lachlanjc/london-smog/README.md

# London Smog

This is a WIP project to experience air quality in VR with physical hardware: an inflatable neck pillow with a programmable air pump.

MIT License
