lachlanjc/london-smog/docs/src/content/docs/index.mdx

---
title: Project overview
description: Get started building your docs site with Starlight.
---

**London Smog** is a story about the history of air quality in London.
It has two parts: a website experience, ideally in VR, and a wearable pillow that inflates around your neck to simulate the air quality throughout the story in a physical way.

Presented at the [2024 ITP Winter Show](https://itp.nyu.edu/shows/winter2024/) in Downtown Brooklyn.

[**View website**](https://london-smog.vercel.app)

[Open source on GitHub](https://github.com/lachlanjc/london-smog)

<script src="https://cdn.jsdelivr.net/npm/@mux/mux-player"></script>

<mux-player
playback-id="vE8WEUNDKz02SDv1LWIsg1Udi02d1h3SECZc02h9vMeBsE"
poster="https://image.mux.com/vE8WEUNDKz02SDv1LWIsg1Udi02d1h3SECZc02h9vMeBsE/thumbnail.jpg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"></mux-player>

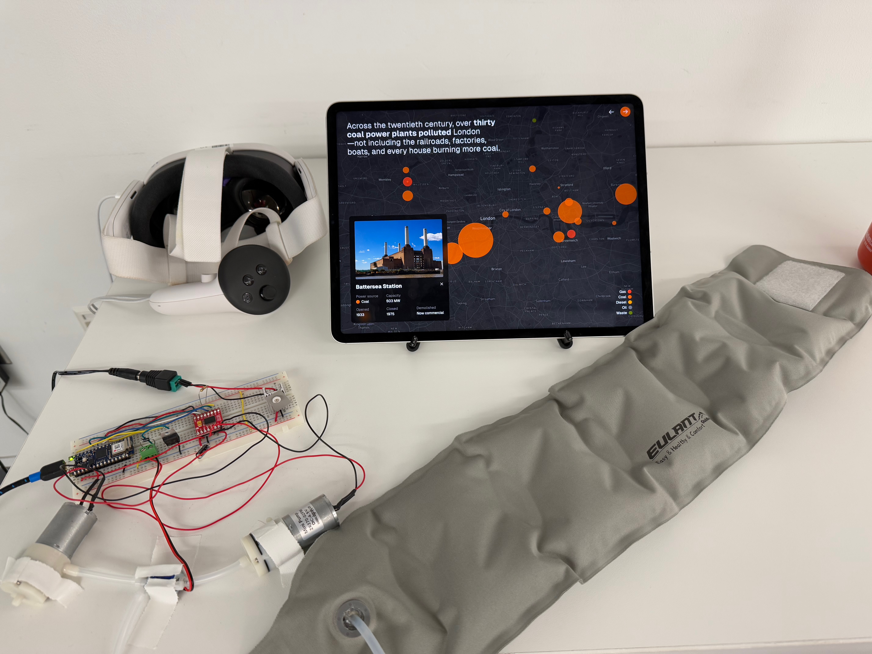
[picture p1: docs/src/assets/home/setup.jpeg]
Grey neck pillow outstretched on a table with a breadboard and air pumps alongside a Meta Quest 3 VR headset and iPad showing a map of London
