lachlanjc/london-smog/docs/src/content/docs/Documentation/inspiration.md

---
title: Inspiration
description: Evergreen
---

## Object

RAINS Bator jacket:

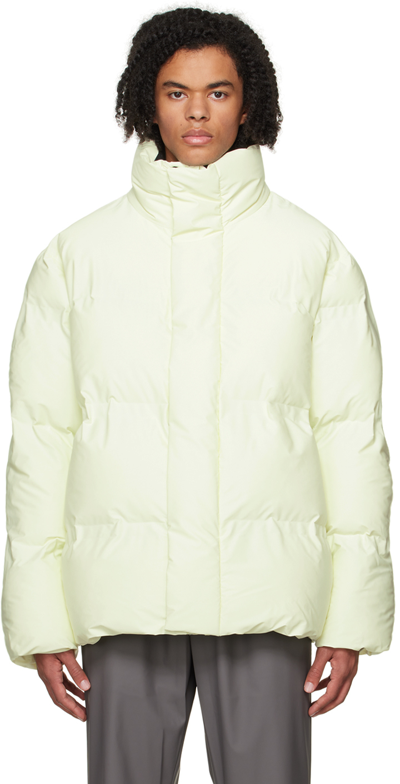
[picture p5: docs/src/assets/inspiration/rains.png]
Rains jacket


## Installation

NYU Berlin gallery opening Fingerfertigkeiten, December 2023:

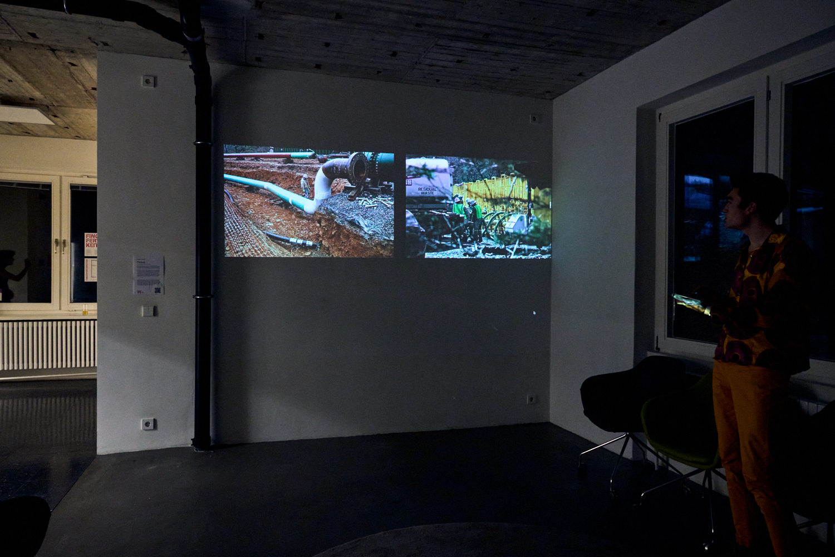
[picture p6: docs/src/assets/inspiration/opening_1.jpg]
Opening 1


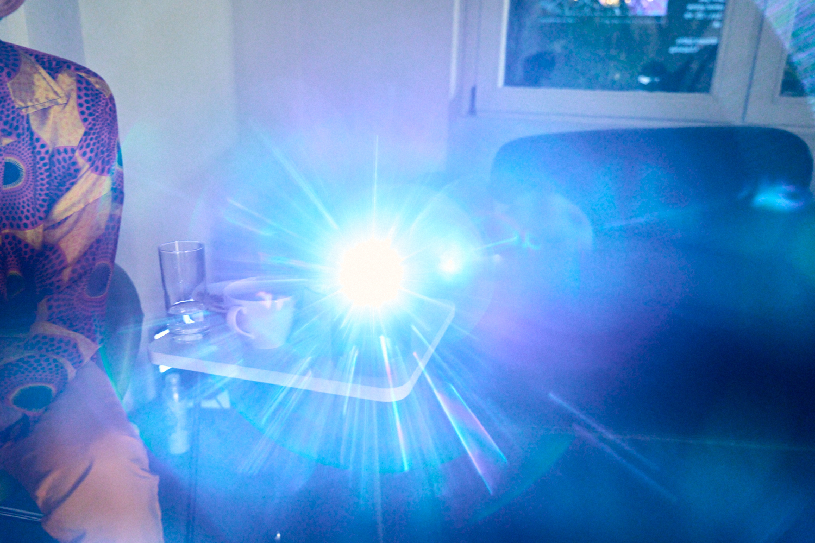
[picture p7: docs/src/assets/inspiration/opening_2.jpg]
Opening 2


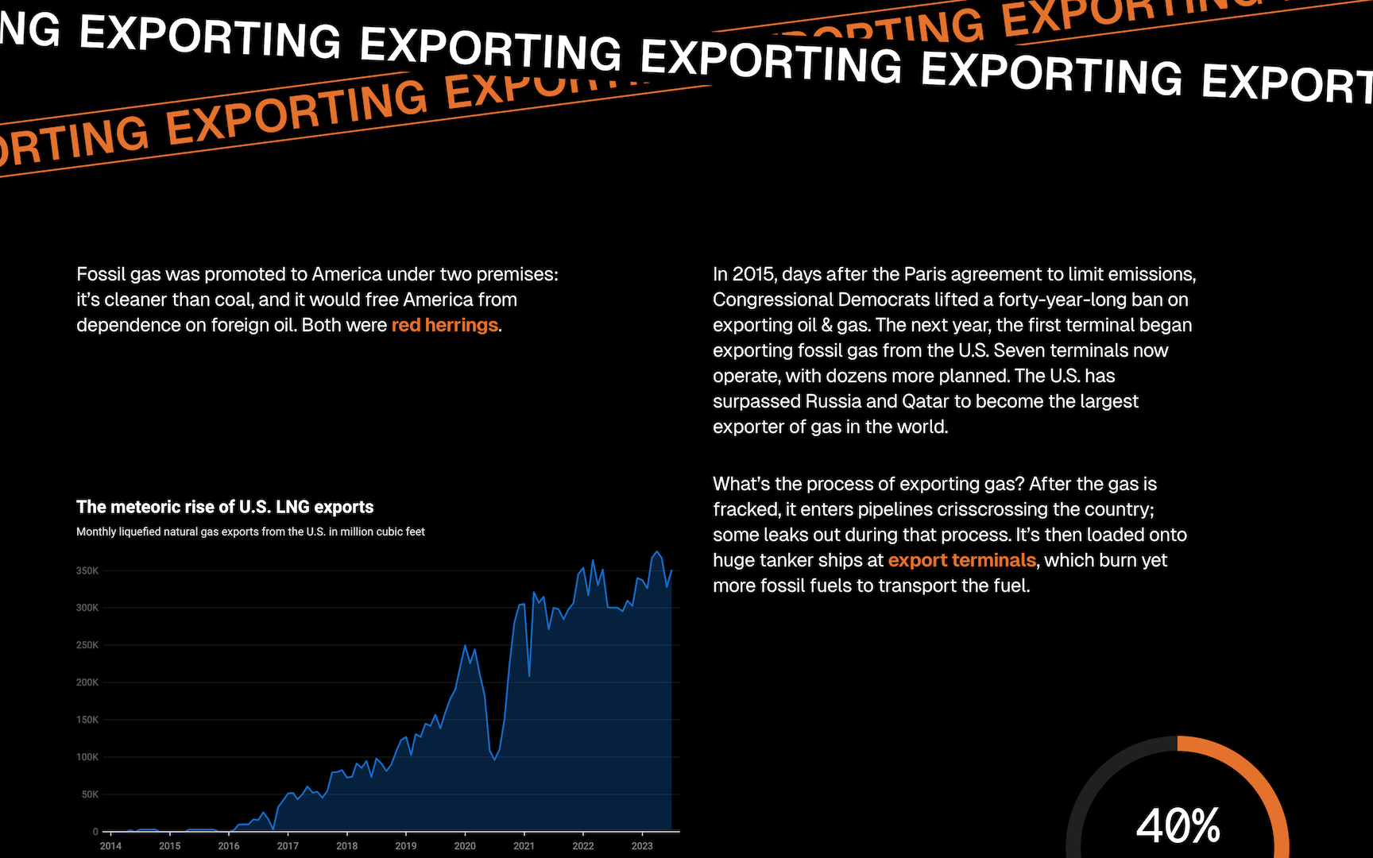
[picture p8: docs/src/assets/inspiration/flareup_story.png]
Flareup storytelling screenshot


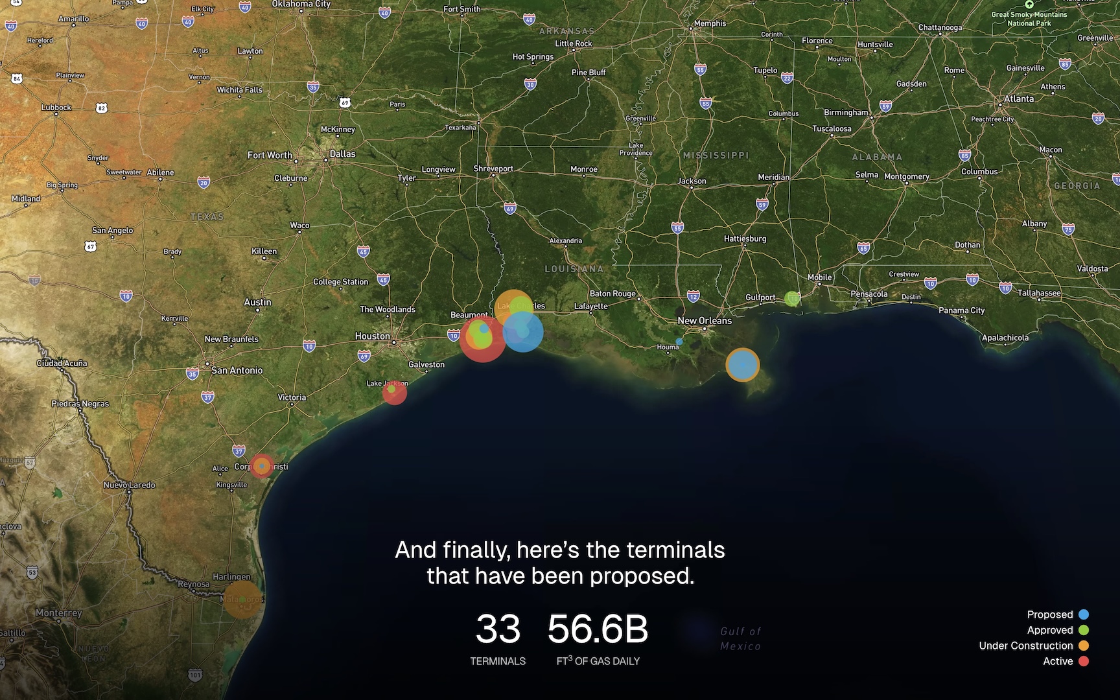
[picture p9: docs/src/assets/inspiration/flareup_map.jpeg]
Flareup map screenshot


## Data/storytelling

[_Our World in Data_: “What the history of London’s air pollution can tell us about the future of today’s growing megacities”](https://ourworldindata.org/london-air-pollution)

Widnes Smoke
