lachlanjc/london-smog/docs/src/content/docs/Past/midterm.md

---
title: Midterm presentation
description: Presented 2024-10-17
---

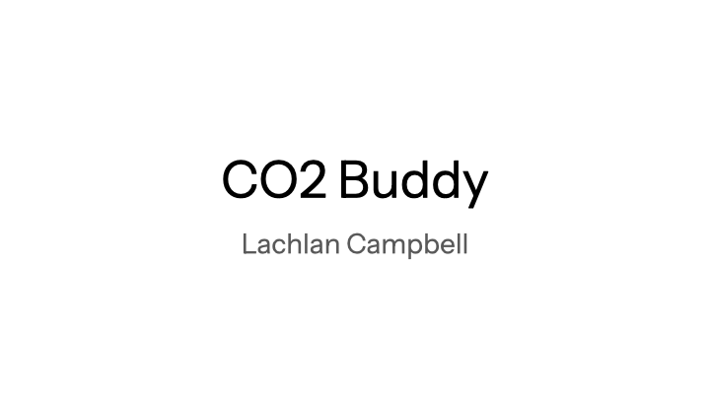
[picture p10: docs/src/assets/midterm/1.png]


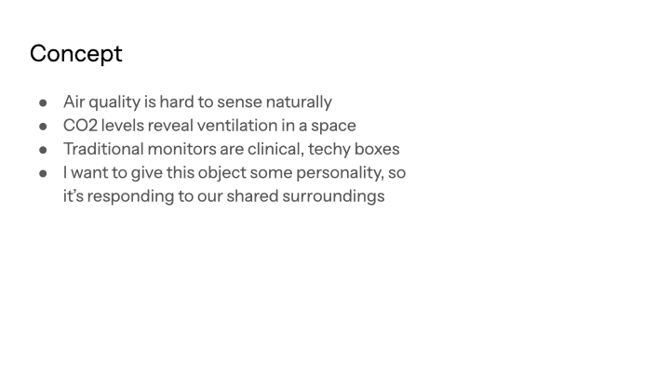
[picture p11: docs/src/assets/midterm/2.png]


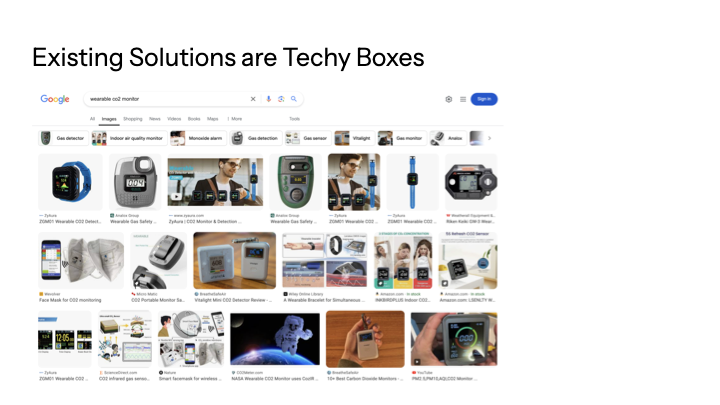
[picture p12: docs/src/assets/midterm/3.png]


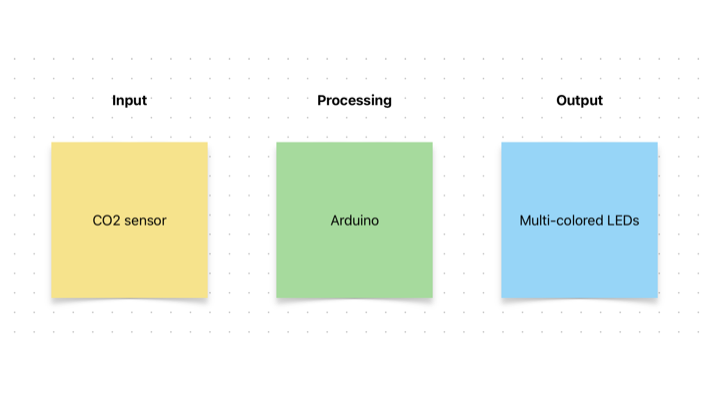
[picture p13: docs/src/assets/midterm/4.png]


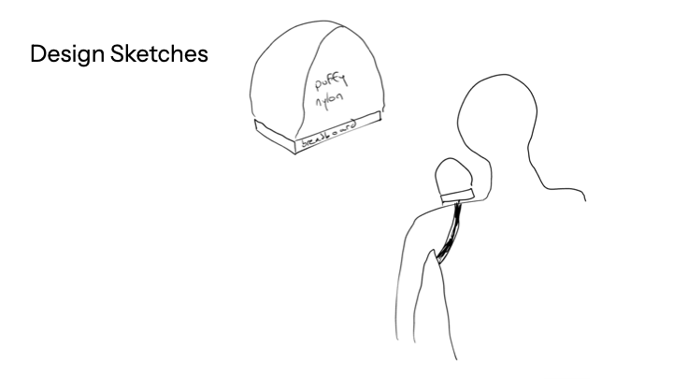
[picture p14: docs/src/assets/midterm/5.png]


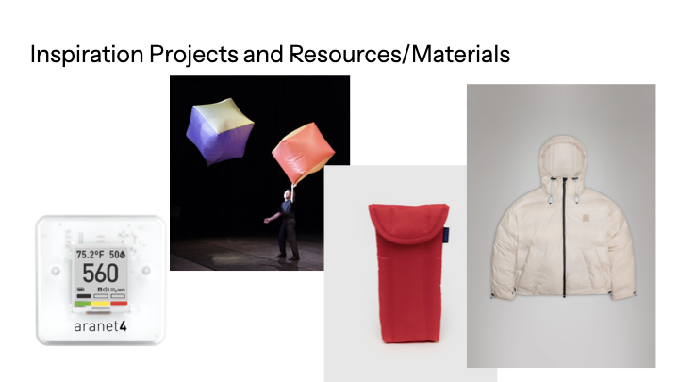
[picture p15: docs/src/assets/midterm/6.png]


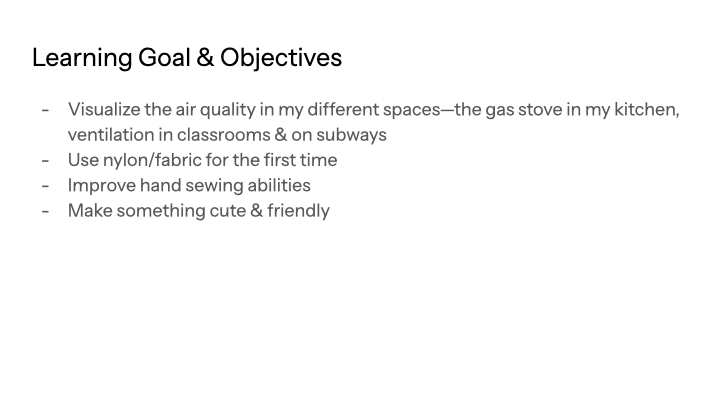
[picture p16: docs/src/assets/midterm/7.png]


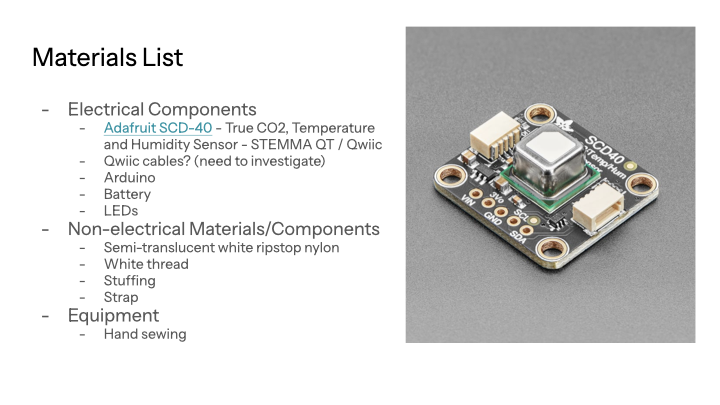
[picture p17: docs/src/assets/midterm/8.png]


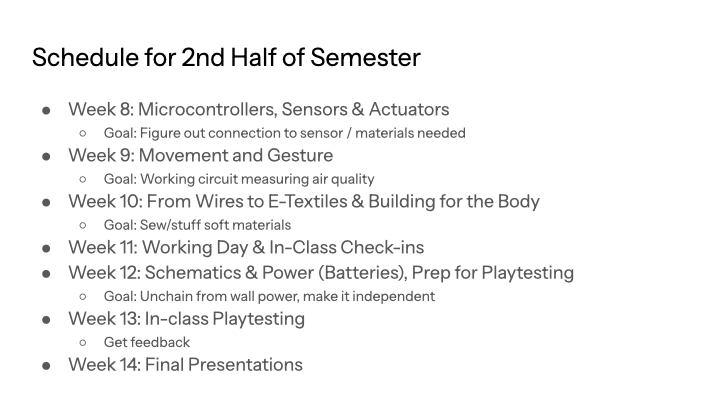
[picture p18: docs/src/assets/midterm/9.png]
