lachlanjc/london-smog/docs/src/assets/6/io_log.png

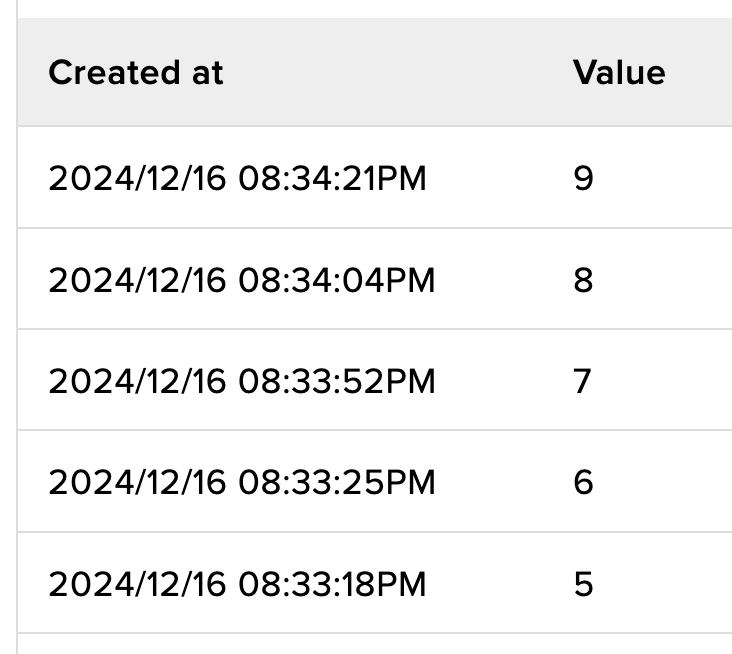
docs/src/assets/6/io_log.png
