lachlanjc/london-smog/docs/src/assets/home/me.jpeg

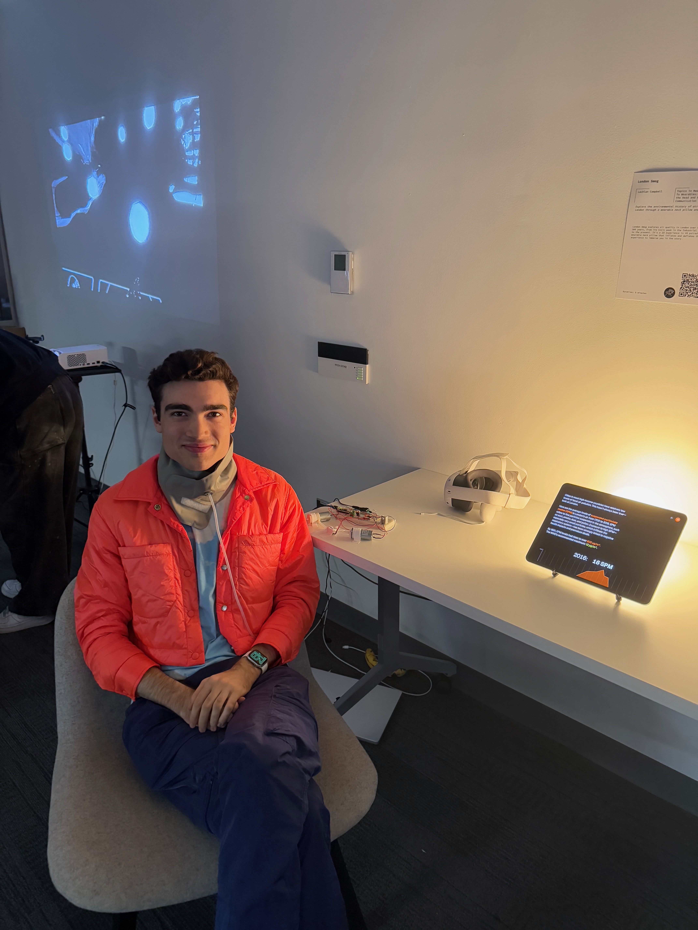
docs/src/assets/home/me.jpeg
