lachlanjc/london-smog/site/src/Air/battersea_crop.webp

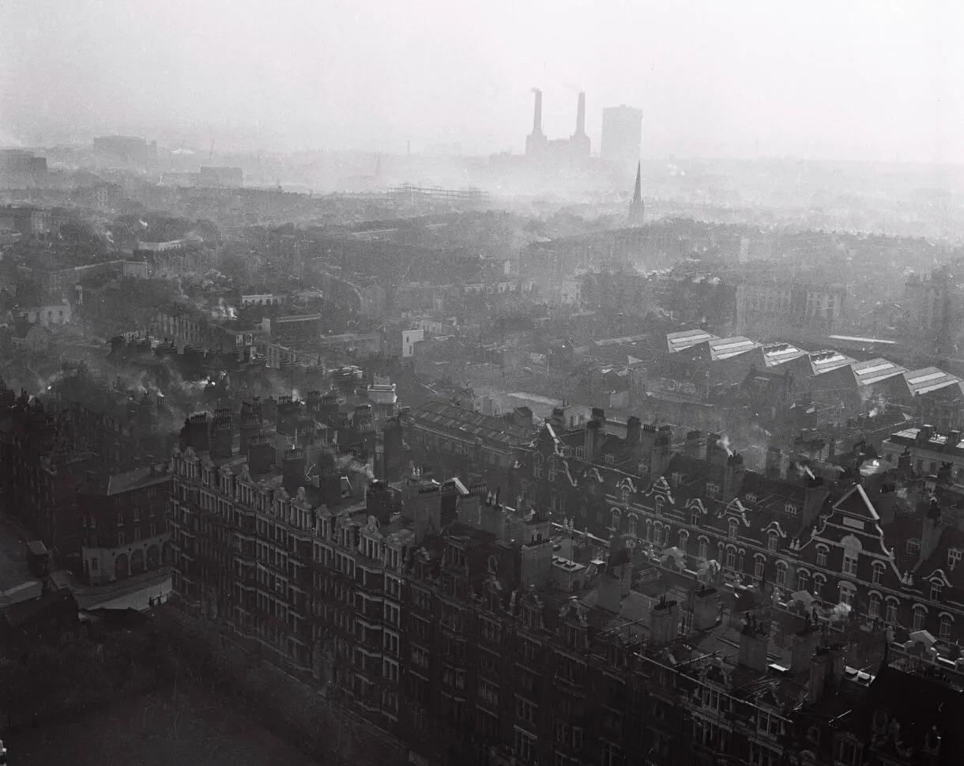
site/src/Air/battersea_crop.webp
