lachlanjc/london-smog/site/src/Air/rooftops.jpeg

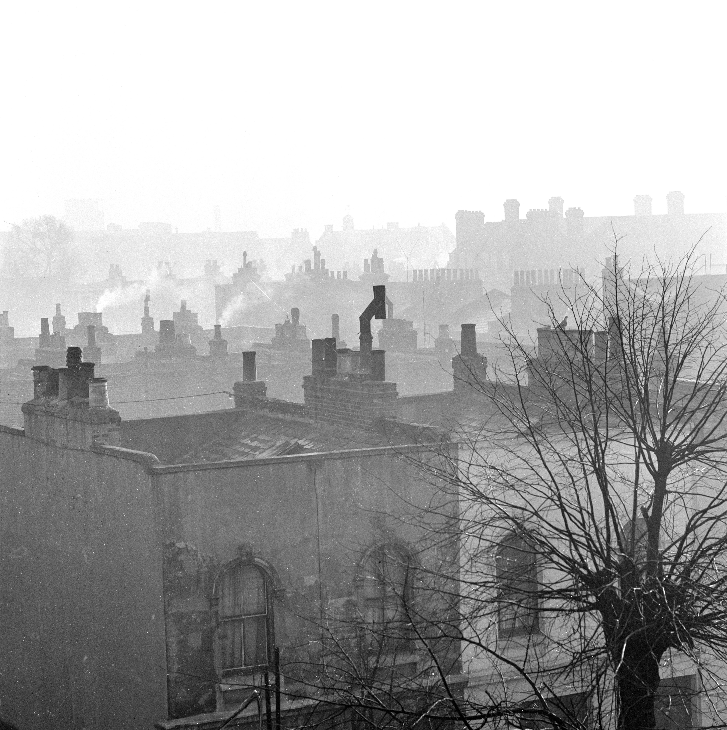
site/src/Air/rooftops.jpeg
