lachlanjc/london-smog/site/src/Air/rooftops.webp

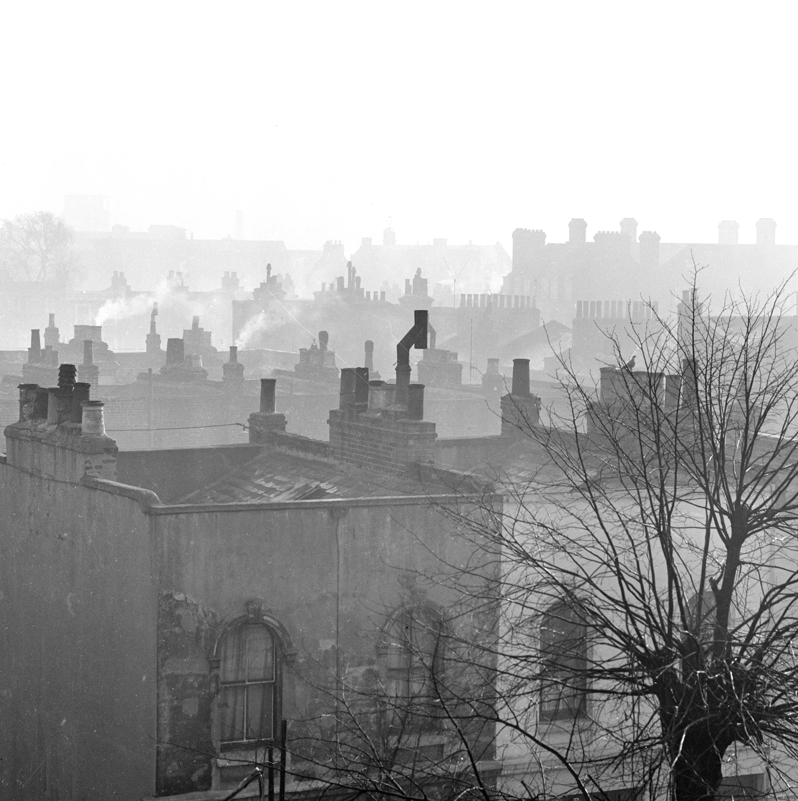
site/src/Air/rooftops.webp
