lachlanjc/london-smog/site/src/Closure/green.webp

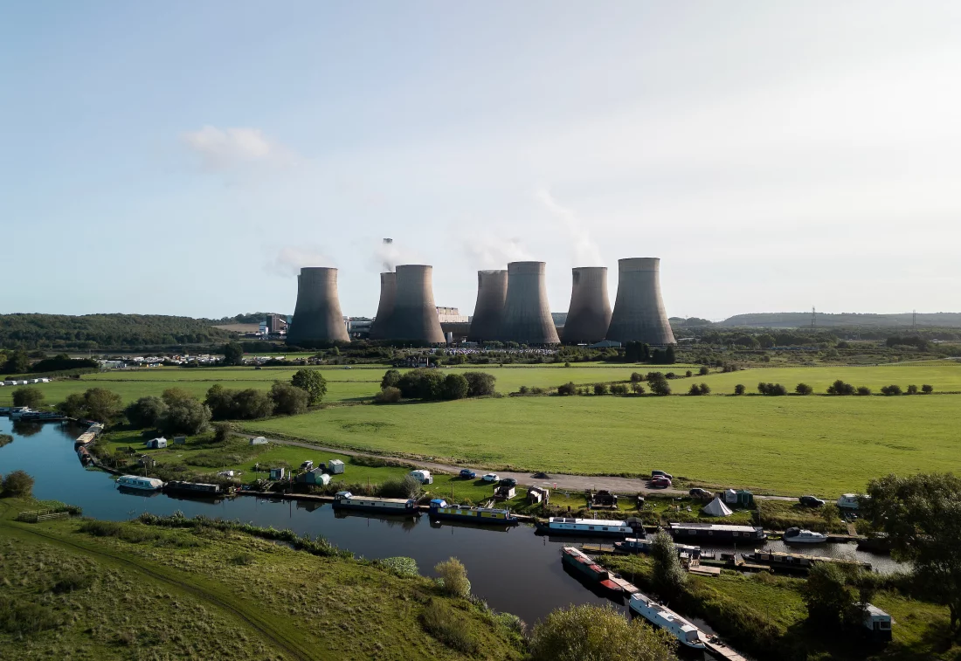
site/src/Closure/green.webp
