lachlanjc/london-smog/site/src/Closure/night.webp

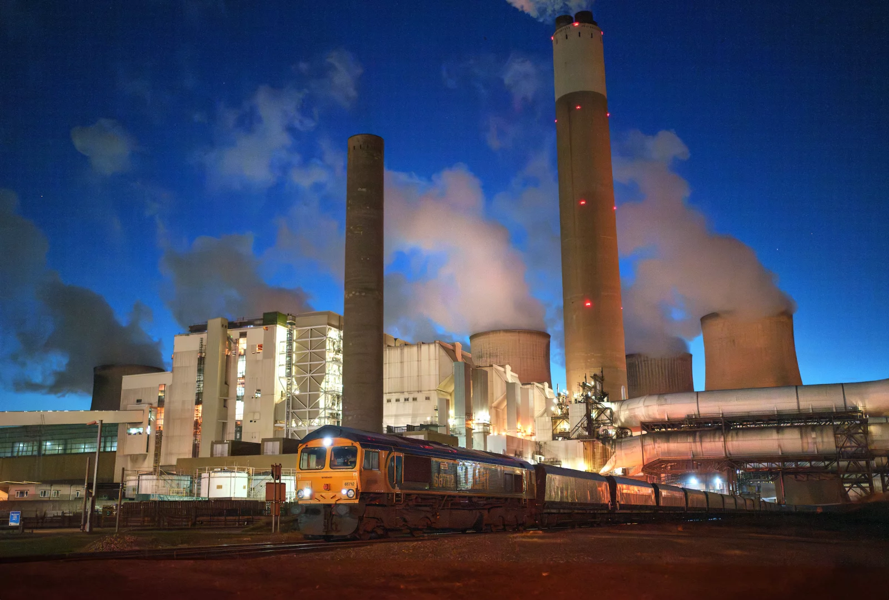
site/src/Closure/night.webp
