lachlanjc/london-smog/site/src/Closure/train.webp

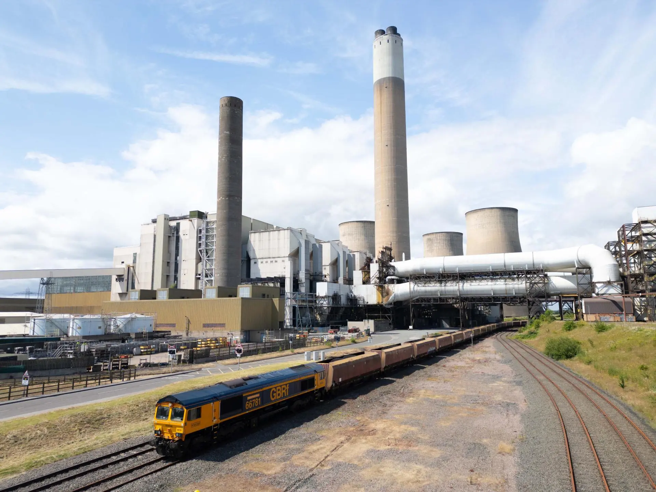
site/src/Closure/train.webp
