lachlanjc/london-smog/site/src/Closure/truck.webp

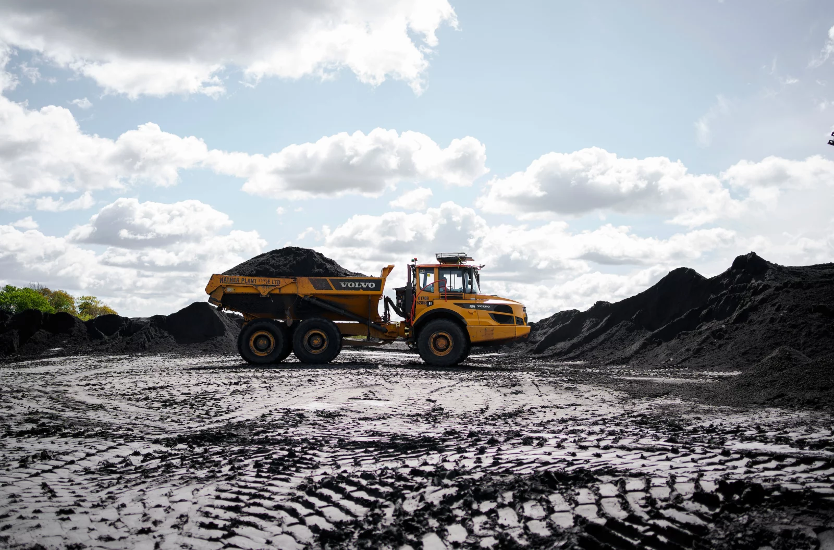
site/src/Closure/truck.webp
