lachlanjc/london-smog/site/src/Coal/boats.webp

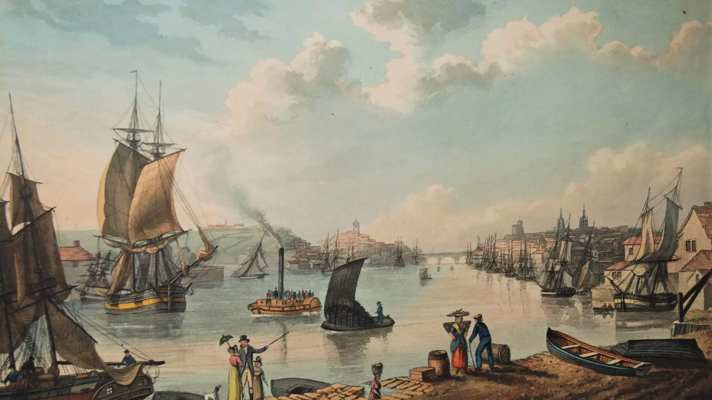
site/src/Coal/boats.webp
