lachlanjc/london-smog/site/src/Coal/landscape.webp

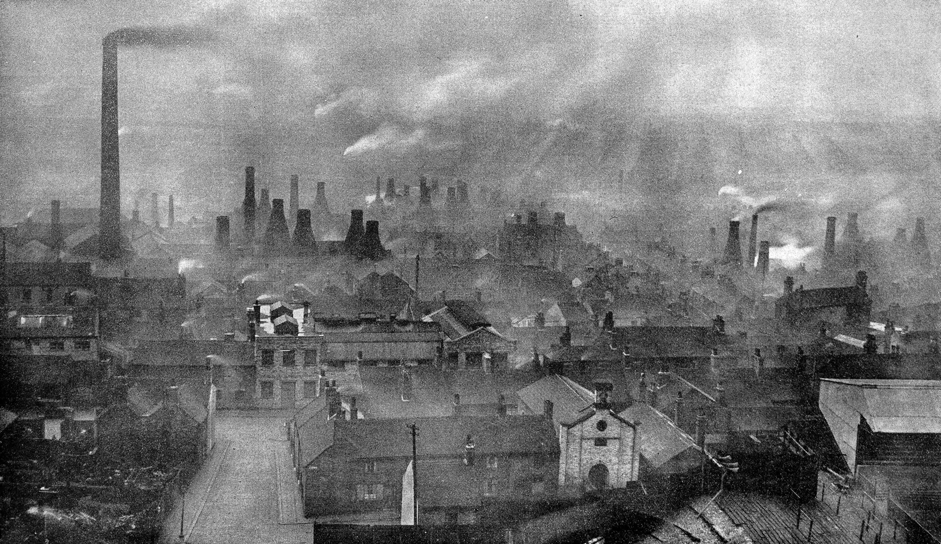
site/src/Coal/landscape.webp
