lachlanjc/london-smog/site/src/Coal/rooftops.webp

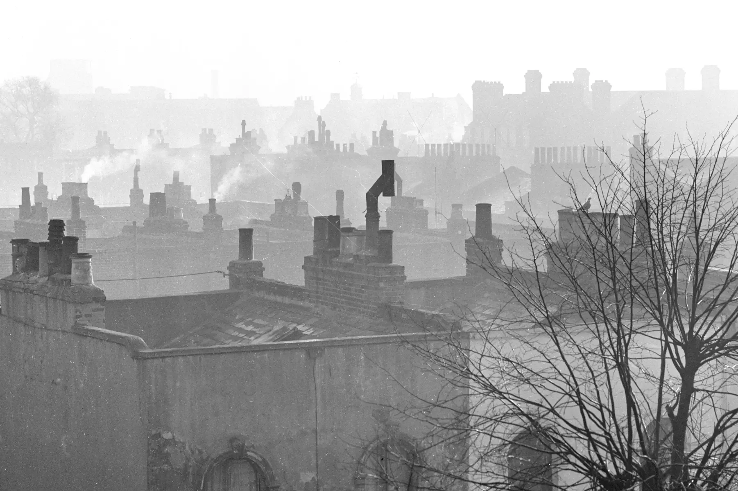
site/src/Coal/rooftops.webp
