lachlanjc/london-smog/site/src/Coal/thomas.webp

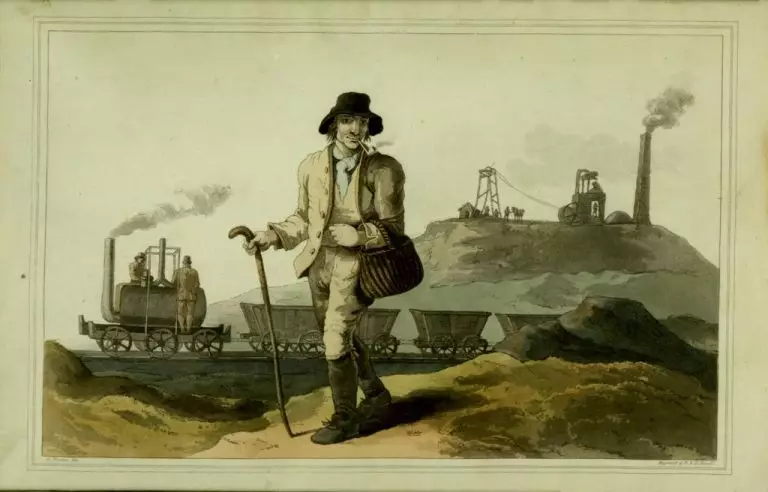
site/src/Coal/thomas.webp
