lachlanjc/london-smog/site/src/Congestion/hero.jpg

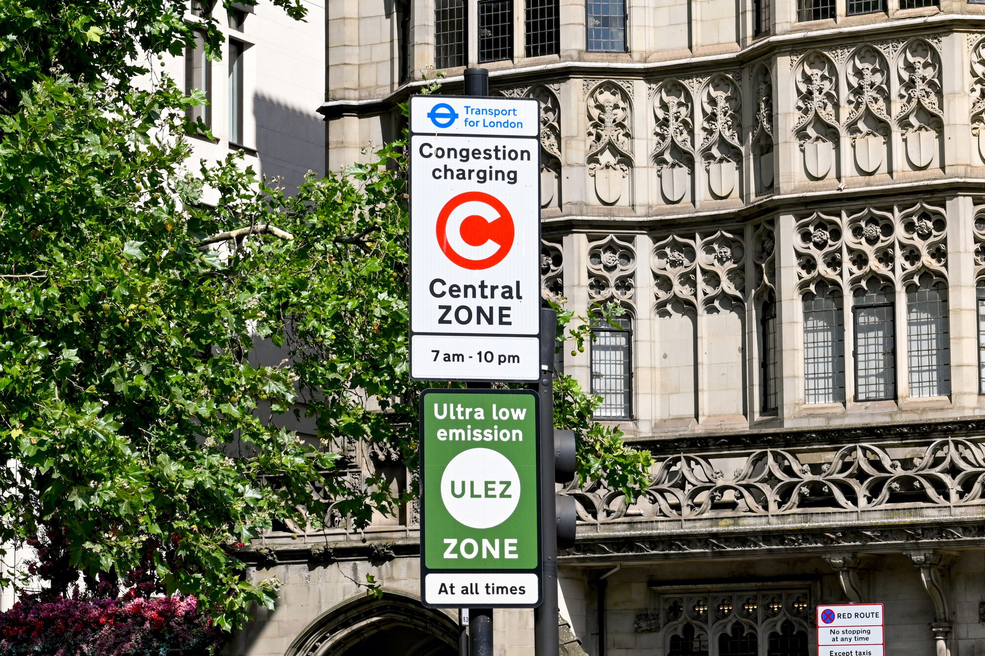
site/src/Congestion/hero.jpg
