lachlanjc/london-smog/site/src/Intro/battersea.webp

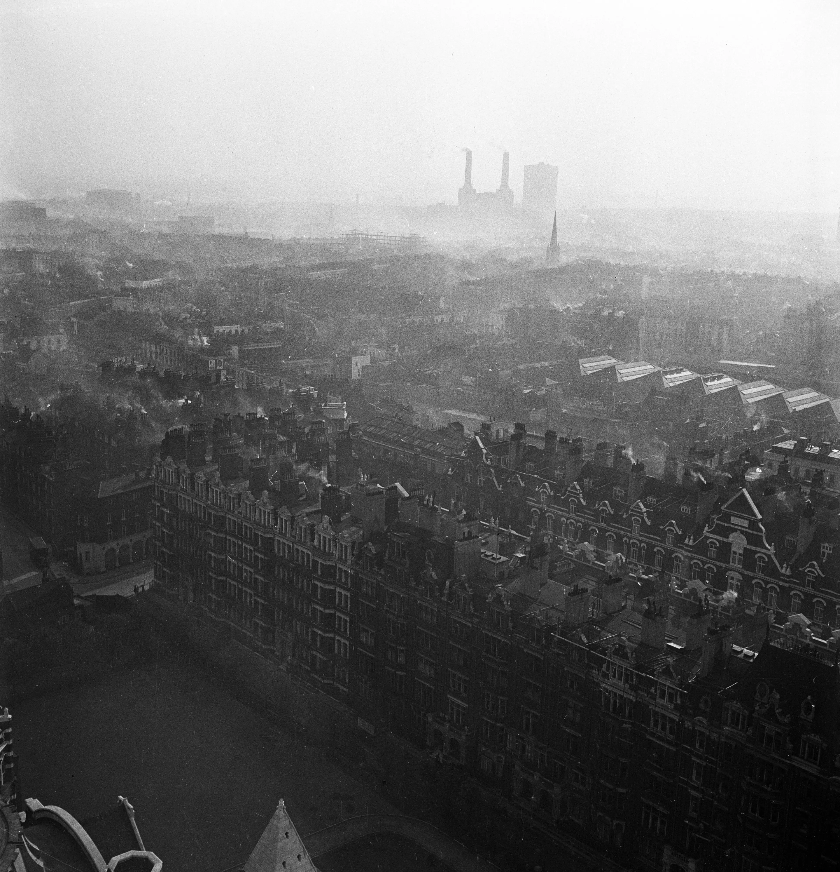
site/src/Intro/battersea.webp
