lachlanjc/london-smog/site/src/Smog/parliament.webp

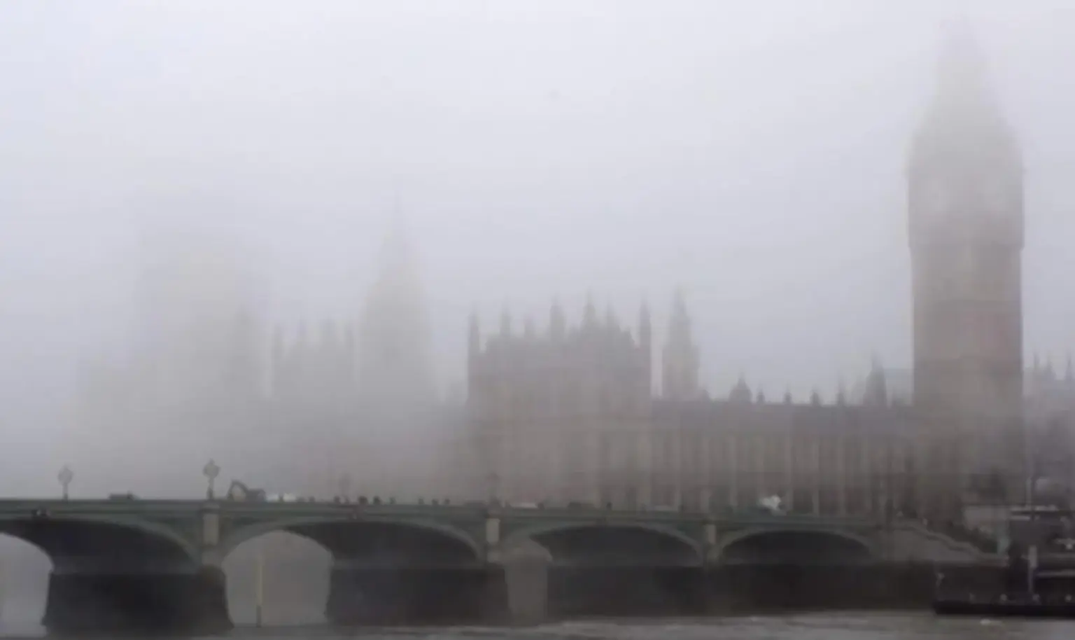
site/src/Smog/parliament.webp
