lachlanjc/london-smog/site/src/Smog/pedestrians.webp

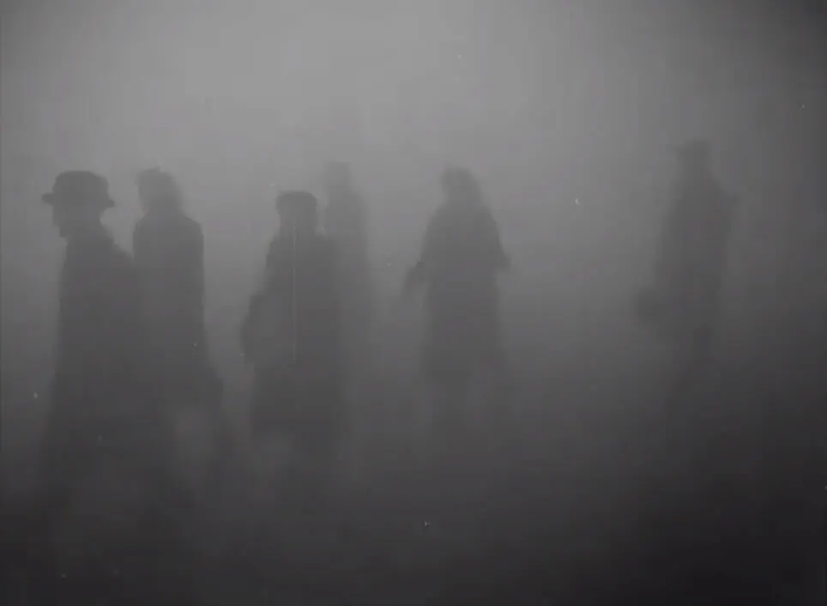
site/src/Smog/pedestrians.webp
