lachlanjc/london-smog/site/src/Solutions/population.jpg

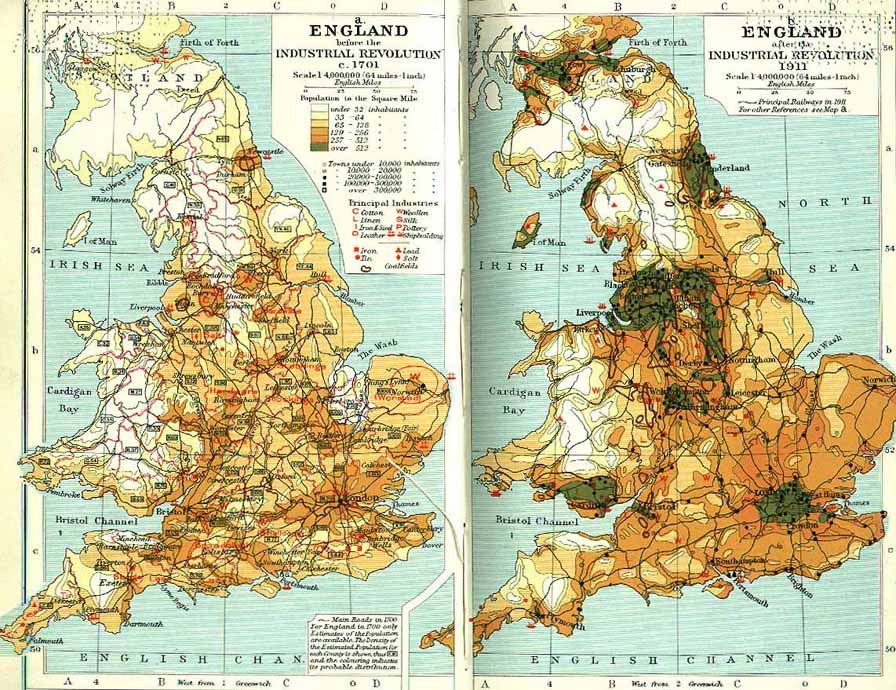
site/src/Solutions/population.jpg
