lachlanjc/london-smog/site/src/Stations/bankside.jpg

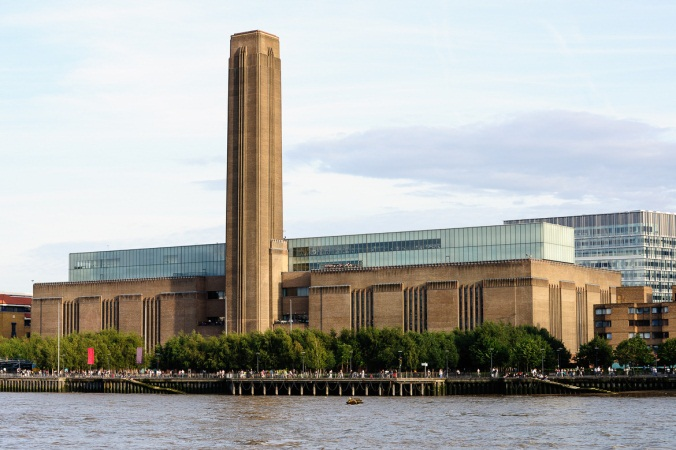
site/src/Stations/bankside.jpg
