lachlanjc/london-smog/site/src/Stations/battersea.jpg

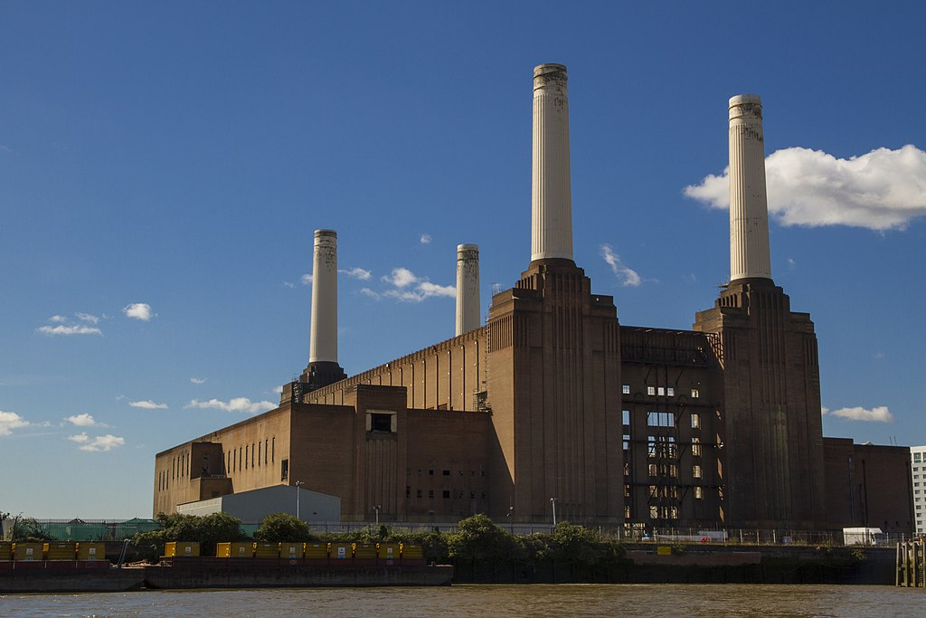
site/src/Stations/battersea.jpg
