lachlanjc/london-smog/docs/src/content/docs/Documentation/materials-supplies.md

---
title: Materials & supplies
description: Evergreen
---

- Electrical components
  - Arduino 33 Nano IoT
  - 9V power supply
  - [Sparkfun motor driver](https://www.sparkfun.com/products/14451)
  - [Air pump](https://www.adafruit.com/product/4699)
  - [Air valve](https://www.adafruit.com/product/4663)
    - TIP102 transistor
    - Diode
  - Meta Quest 3/Apple Vision Pro
- Non-electrical Materials/Components
  - [Inflatable neck pillow](https://www.amazon.com/gp/product/B0CY1LLKYM?th=1)
  - [Silicone tubing](https://www.adafruit.com/product/4661)
  - Gasket?
- Software
  - Adafruit IO
  - React/Tailwind CSS/Recharts on Vercel
