lachlanjc/london-smog/docs/src/content/docs/Documentation/fabrication.md

---
title: Fabrication plan
description: Evergreen
---

## System diagram

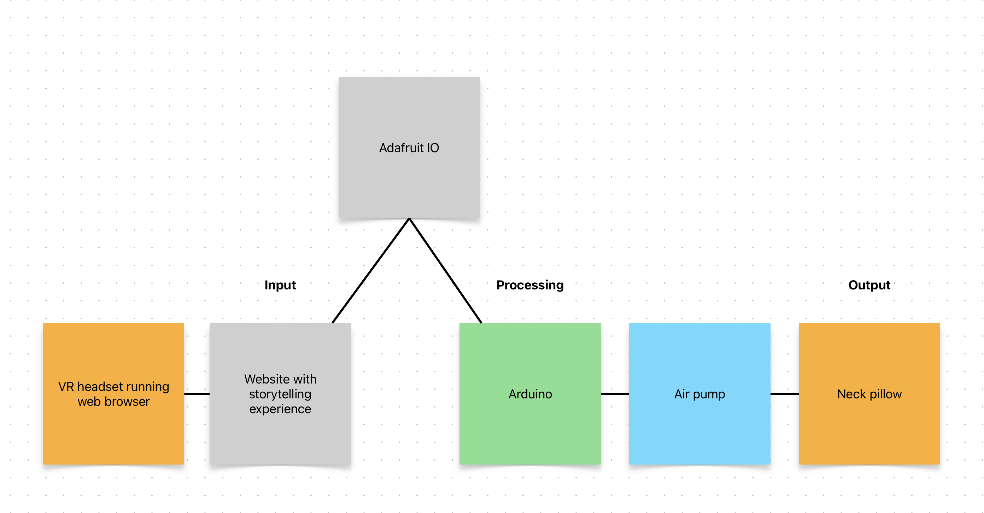
[picture p39: docs/src/assets/fab/diagram.png]
Diagram


## Circuit diagram

<iframe height="720" width="720" allowfullscreen frameBorder="0" src="https://www.flux.ai/lachlanjcnyu/london-smog?embed=1&editor=schematic" style="aspect-ratio: 1 / 1"></iframe>

## Component datasheets

### Arduino

<object data="https://docs.arduino.cc/resources/datasheets/ABX00027-datasheet.pdf" width="100%" height="512"></object>

### Air pump

<object data="/datasheets/pump.pdf" width="100%" height="512"></object>

### Air valve

<object data="/datasheets/valve.pdf" width="100%" height="512"></object>

### Air valve transistor

<object data="/datasheets/TIP102.pdf" width="100%" height="512"></object>

### Voltage regulator

<object data="/datasheets/LM7805.pdf" width="100%" height="512"></object>

## Photos

TK
