lachlanjc/london-smog/arduino/io/config.h

/************************ Adafruit IO Config *******************************/

// visit io.adafruit.com if you need to create an account,
// or if you need your Adafruit IO key.
#define IO_USERNAME "lachlanjc"
#define IO_KEY ""

/******************************* WIFI **************************************/

#define WIFI_SSID "sandbox370"
#define WIFI_PASS "+s0a+s03!2gether?"

// uncomment the following line if you are using airlift
// #define USE_AIRLIFT

// uncomment the following line if you are using winc1500
// #define USE_WINC1500

// uncomment the following line if you are using mrk1010 or nano 33 iot
#define ARDUINO_SAMD_MKR1010

// comment out the following lines if you are using fona or ethernet
#include "AdafruitIO_WiFi.h"

#if defined(USE_AIRLIFT) || defined(ADAFRUIT_METRO_M4_AIRLIFT_LITE) ||         \
    defined(ADAFRUIT_PYPORTAL)
// Configure the pins used for the ESP32 connection
#if !defined(SPIWIFI_SS) // if the wifi definition isnt in the board variant
// Don't change the names of these #define's! they match the variant ones
#define SPIWIFI SPI
#define SPIWIFI_SS 10 // Chip select pin
#define NINA_ACK 9    // a.k.a BUSY or READY pin
#define NINA_RESETN 6 // Reset pin
#define NINA_GPIO0 -1 // Not connected
#endif
AdafruitIO_WiFi io(IO_USERNAME, IO_KEY, WIFI_SSID, WIFI_PASS, SPIWIFI_SS,
                   NINA_ACK, NINA_RESETN, NINA_GPIO0, &SPIWIFI);
#else
AdafruitIO_WiFi io(IO_USERNAME, IO_KEY, WIFI_SSID, WIFI_PASS);
#endif
