lachlanjc/london-smog/(commit log)

2024-11-05 Begin project
    [cities.csv]
2024-11-13 Switch site to Adafruit IO
2024-11-13 Add number flow
2024-12-05 Begin coal chart
    [coal.csv]
2024-12-05 Make real site
    [stations.csv]
2024-12-05 Add schematic
2024-12-14 Fix schematic embed
